MauriceChocoSwiss/FCUWOLVERINE/BOM_PCB V3_2022-01-27.csv

ID | Name | Designator | Footprint | Quantity | Manufacturer Part | Manufacturer | Supplier | Supplier Part
1 | 1K | R7 | R1206 | 1 | 1206W4F1001T5E | UniOhm | LCSC | C4410
2 | RF201L2STE25 | D1 | SOD-106_L4.5-W2.6-LS5.0-RD | 1 | RF201L2STE25 | ROHM Semicon | LCSC | C919452
3 | 3.3K | R13 | R1206 | 1 | RTT06332JTP | RALEC | LCSC | C104771
4 | 1K | R10,R9,R14,R3,R1,R8,R2,R12,R11 | R1206 | 9 | CR1206F41001G | LIZ | LCSC | C102060
5 | 1.1K | R15 | R1206 | 1 | RM12FTN1101 | TA-I Tech | LCSC | C188082
6 | 220 | R16,R4,R5,R6 | R1206 | 4 | CR1206F42200G | LIZ | LCSC | C102128
7 | AO3400_C382311 | Q1 | SOT-23-3_L2.9-W1.3-P0.95-LS2.4-BR | 1 | AO3400 | KEXIN | LCSC | C382311
8 | SM05B-GHS-TB(LF)(SN) | P1 | CONN-SMD_5P-P1.25_SM05B-GHS-TB-LF-SN | 1 | SM05B-GHS-TB(LF)(SN) | JST Sales America | LCSC | C189896
