MauriceChocoSwiss/FCUWOLVERINE/FCU-Wolverine/VoltageCtrl.cpp

#include "VoltageCtrl.h"

unsigned long previousMillisAlarm = 0;
uint16_t lowBatteryCount = 0;


unsigned int analogReadReference(void) {


	ADMUX = 0x4F;
	delayMicroseconds(5);


	ADMUX = 0x4E;
	delayMicroseconds(200);


	ADCSRA |= (1 << ADEN);


	ADCSRA |= (1 << ADSC);

	/* Attend la fin de la conversion */
	while (ADCSRA & (1 << ADSC));


	return ADCL | (ADCH << 8);
}

VoltageCtrl::VoltageCtrl() {
}

double VoltageCtrl::VoltageValue(uint8_t pin) {
	return (((analogRead(pin) * 1.1) / analogReadReference()) * 4) - 0.20;
}

bool VoltageCtrl::alarmVoltage(uint8_t voltValue, unsigned long currentMillis) {
	if (currentMillis - previousMillisAlarm >= 30000) {
		if (voltValue < 6) {
			lowBatteryCount++;
		}

		previousMillisAlarm = currentMillis;

		if (lowBatteryCount >= 1000) { return true; }
	}
	return false;
}
