MauriceChocoSwiss/FCUWOLVERINE/(commit log)

2018-07-26 Gerber file for PCB
2018-07-26 Add gerber file of PCB
2018-09-07 Correction mode sniper, alarme avec led et buzzer, mode de tir en fonction du selecteur
2018-09-12 Ajout de la lecture du voltage et de ml'alarme voltage BAS
2018-09-19 Rotation de l'écran et du joystick pour l'adapter a ma configuration
2019-05-17 Mise a jour du système de délai
2020-03-08 Adding PDF for schematics and components
2021-03-02 Mise ajour pour les délais et améliorer la réactivité du FCU
2021-03-12 Augmentation de la valeur max du dwel
2021-03-17 Mise valeur de tension
2021-06-23 Maj suite a erreur lors de la dernière maj
2022-01-29 Add a GOTO to up reactiveness by by-passing screen functions Add a delay on voltage control to reduce latency Refactorisation
    [BOM_PCB V3_2022-01-27.csv]
2022-03-03 Saving to EEPROM Correction Test
    [FCU-Wolverine.ino]
2022-03-03 Fix menus and EEPROM saving issues
    [FCU-Wolverine.ino, Menu.cpp, Menu.h]
2022-03-19 Value name change and digital input value change for LED due to a mistake on the V1 PCB
    [FCU-Wolverine.ino]
2022-03-22 Correcting digital input value for trigger and selector
    [FCU-Wolverine.ino]
2022-10-15 Correction du fonctionnement du vérouillage de l'écran
    [FCU-Wolverine.ino]
2022-11-10 Update BOM and add CPL File
    [BOM_PCB V3_2022-01-27.csv, PickAndPlace_PCB V3_2022-11-10.csv]
2026-08-01 Fix center push button for programming mode
    [FCU-Wolverine.ino]
2026-10-24 Improve speed of voltage control process and adjust values
    (cherry picked from commit 56d4a7751ca38a7f2e5a1eee769efd9f12ed4b36)
